tuandangha2213764/Dc_motor_control/Design/HW/Mapping_pin.png

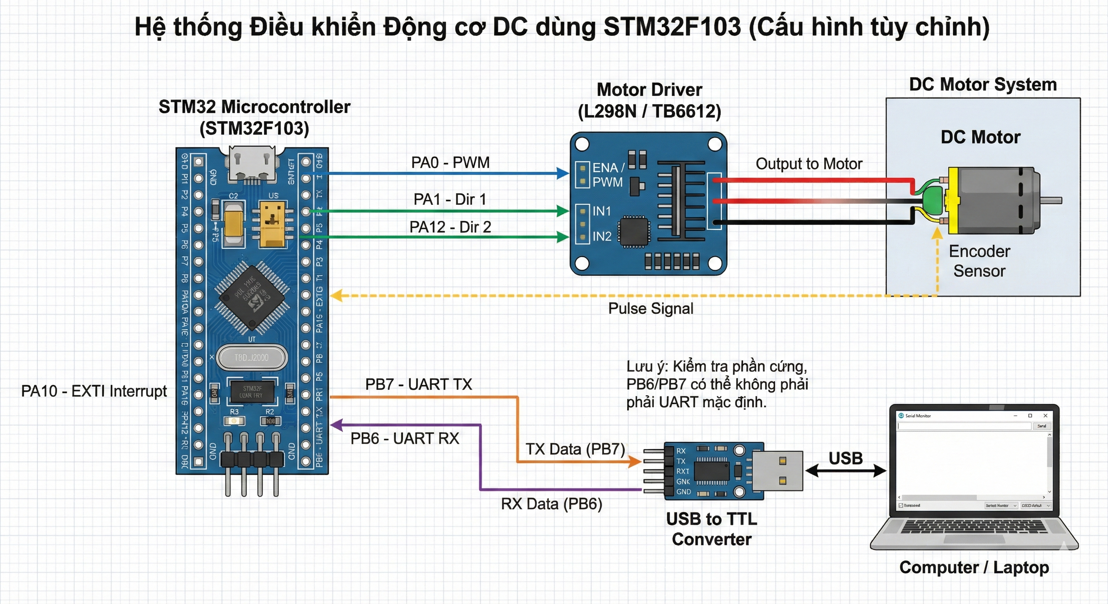
Design/HW/Mapping_pin.png
