tuandangha2213764/Dc_motor_control/(list of files, drawings)

Other design files:
Design/HW/PCB.PcbDoc
