tuandangha2213764/Dc_motor_control/(commit log)

2025-11-30 Update mapping pin and ver 5 GUI
2025-12-11 Add final PCB.doc ver
    [PCB.PcbDoc]
